johnboyington/mpfd_related/drawings/INL_Disk.sldprt

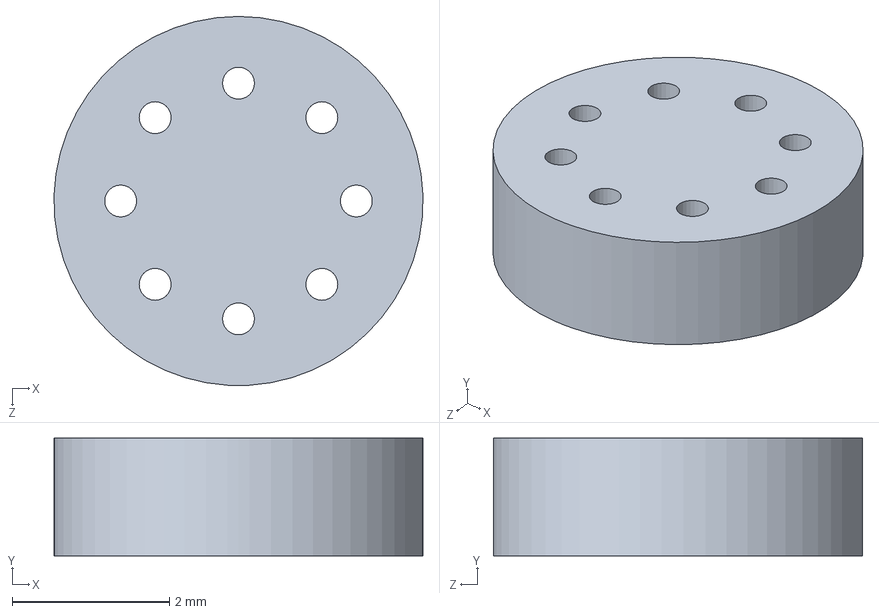
[picture p24: CAD file, 2017-07-19]
drawings/INL_Disk.sldprt
4.70 x 1.50 x 4.70 mm
