johnboyington/mpfd_related/drawings/INL_Spacer.sldprt

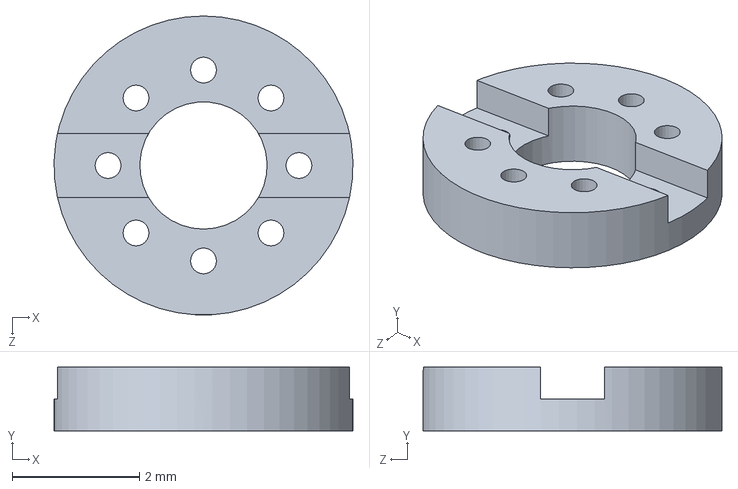
[picture p25: CAD file, 2017-07-19]
drawings/INL_Spacer.sldprt
4.70 x 1.00 x 4.70 mm
