johnboyington/mpfd_related/drawings/INL_Disk.pdf

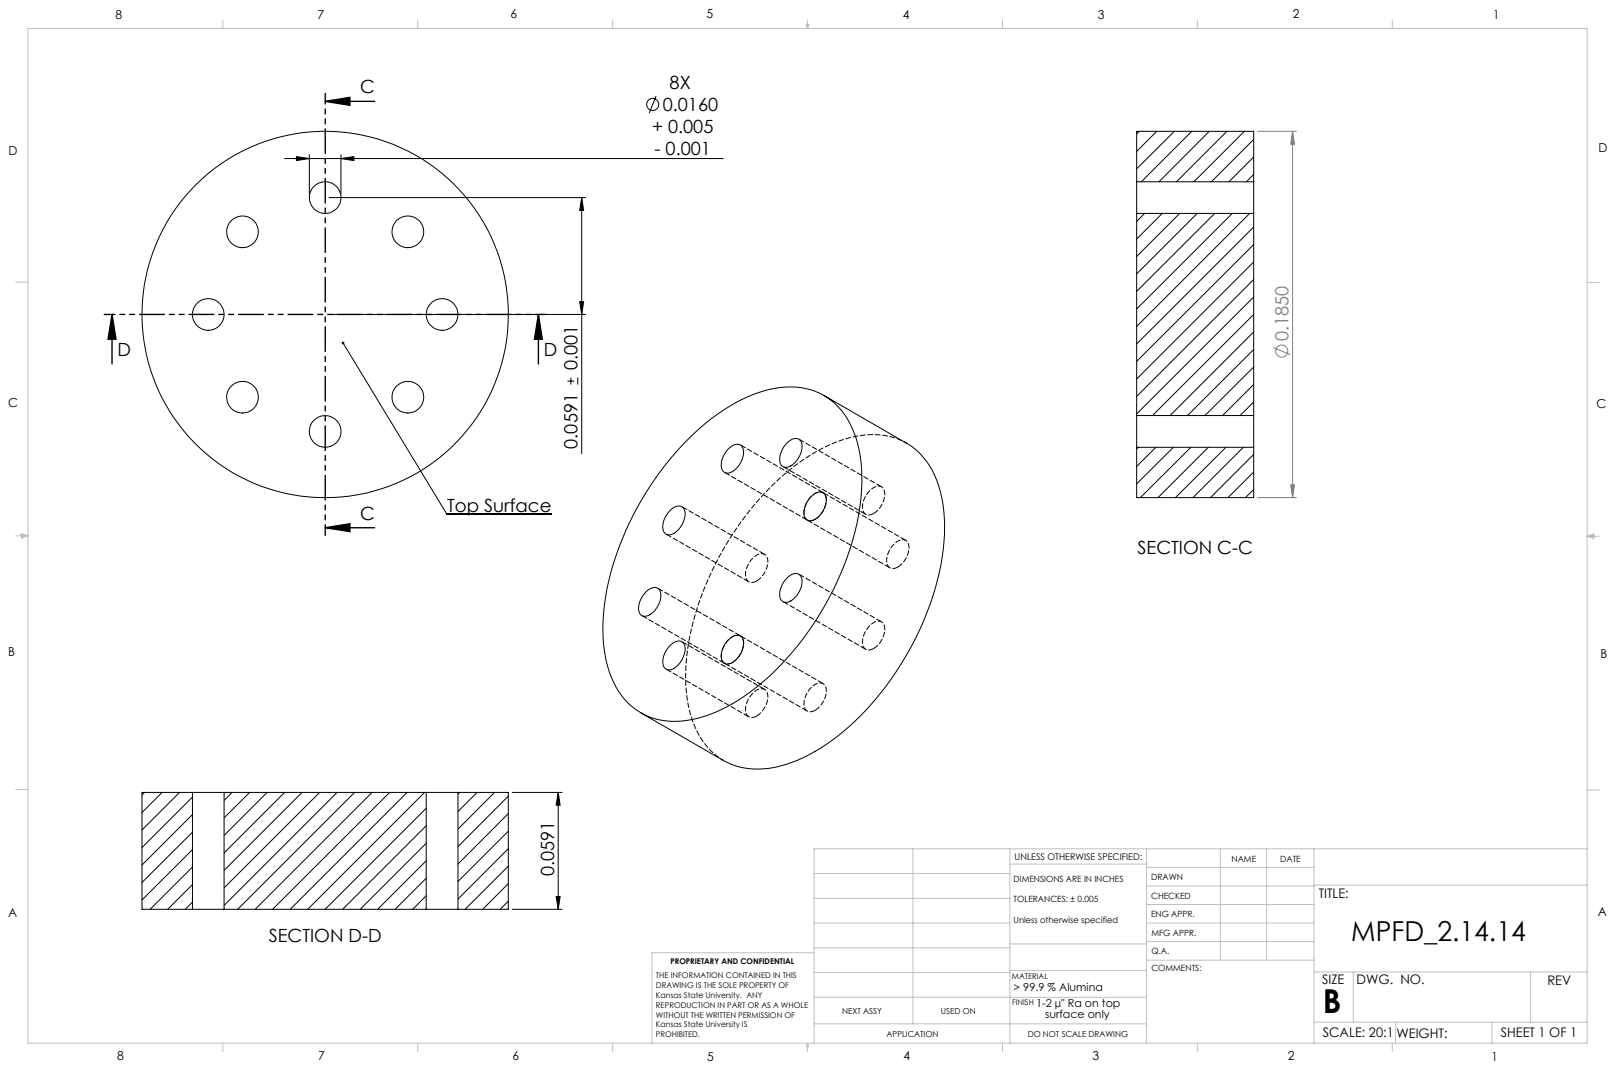
[picture p27: page 1]
Top Surface; SECTION C-C; SECTION D-D; NEXT ASSY; USED ON; ENG APPR.; MFG APPR.; DWG. NO.; REV; SCALE: 20:1 WEIGHT:; SHEET 1 OF 1

UNLESS OTHERWISE SPECIFIED:

DIMENSIONS ARE IN INCHES
TOLERANCES: ± 0.005
Unless otherwise specified

PROPRIETARY AND CONFIDENTIAL
THE INFORMATION CONTAINED IN THIS
DRAWING IS THE SOLE PROPERTY OF
Kansas State University. ANY
REPRODUCTION IN PART OR AS A WHOLE
WITHOUT THE WRITTEN PERMISSION OF
Kansas State University IS
PROHIBITED.

MATERIAL
> 99.9 % Alumina
1-2 µ" Ra on top
FINISH
surface only

DO NOT SCALE DRAWING
