johnboyington/mpfd_related/(commit log)

2017-07-19 initialized with info from previous attempt to model
    [INL_Disk.sldprt, INL_Spacer.sldprt]
2017-07-26 Nodes 0 and 3 reflect proper material, 93% HEU instead of Nat
